markaudacity/Z88-Flash-Card/Z88 Flash KiCad/net report.csv

Net Code | Net Name | Pad Count | Via Count | Via Length (mm) | Track Length (mm) | Die Length (mm) | Net Length (mm) | F.Cu (mm) | In1.Cu (mm) | In2.Cu (mm) | B.Cu (mm)
001 | GND | 16 | 7 | 10.8150 | 51.6775 | 0.0000 | 62.4925 | 51.6775 | 0.0000 | 0.0000 | 0.0000
002 | VCC | 12 | 0 | 0.0000 | 134.6626 | 0.0000 | 134.6626 | 134.6626 | 0.0000 | 0.0000 | 0.0000
003 | /D2 | 4 | 3 | 2.9550 | 53.4608 | 0.0000 | 56.4158 | 16.6270 | 19.7758 | 17.0580 | 0.0000
004 | /D1 | 4 | 3 | 2.9550 | 55.8959 | 0.0000 | 58.8509 | 17.7764 | 20.1144 | 18.0051 | 0.0000
005 | /A14 | 4 | 4 | 4.3650 | 99.7862 | 0.0000 | 104.1512 | 13.5033 | 44.5184 | 41.7645 | 0.0000
006 | /D0 | 4 | 3 | 2.9550 | 53.8250 | 0.0000 | 56.7800 | 16.3816 | 20.3295 | 17.1139 | 0.0000
007 | /A13 | 4 | 4 | 3.0900 | 106.4675 | 0.0000 | 109.5575 | 14.3991 | 74.9579 | 17.1106 | 0.0000
008 | /A0 | 4 | 3 | 2.9550 | 65.6960 | 0.0000 | 68.6510 | 19.1505 | 28.4713 | 18.0742 | 0.0000
009 | /A8 | 4 | 4 | 3.0900 | 95.7026 | 0.0000 | 98.7926 | 18.8896 | 65.4914 | 11.3216 | 0.0000
010 | /A1 | 4 | 3 | 2.9550 | 54.8601 | 0.0000 | 57.8151 | 17.3188 | 20.4307 | 17.1106 | 0.0000
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
