markaudacity/Z88-Flash-Card/doc/z88-flash-mod.pdf

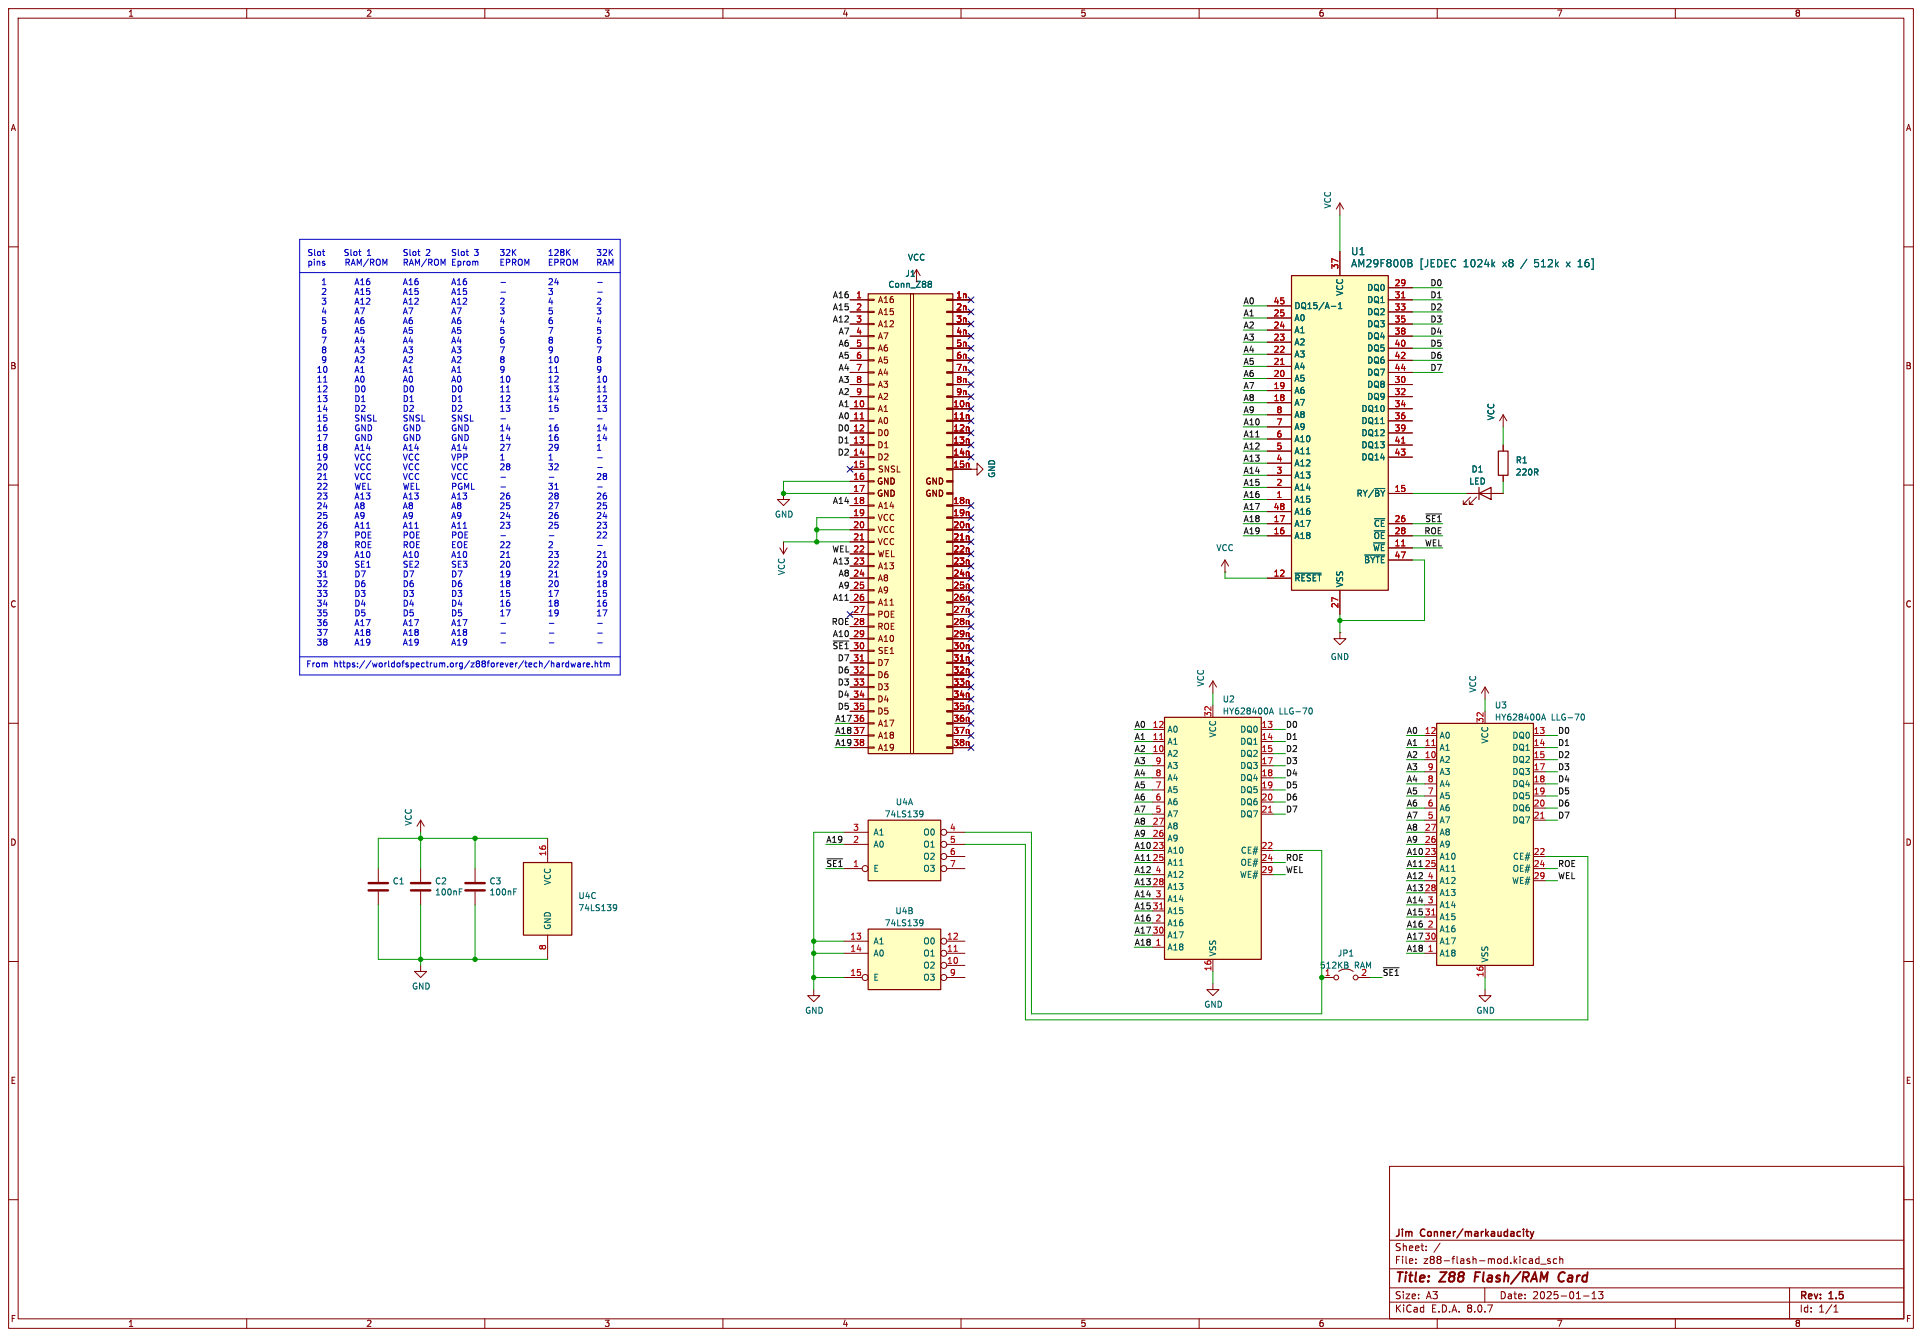
[picture p3: page 1]

17 GND GND GND 14 16 14
19 VCC VCC VPP 1 1 - 20 VCC VCC VCC 28 32 - 21 VCC VCC VCC - - 28

Id: 1/1 Title: Z88 Flash/RAM Card
