markaudacity/Z88-Flash-Card/(commit log)

2025-01-02 initial upload of modified files, removal of upstream files
    [connector.kicad_pcb, connector.kicad_sch, net report.csv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]
2025-01-02 removed connector-backups dir
2025-01-02 new Gerbers
    [z88-flash-mod-B_Cu.gbr, z88-flash-mod-B_Mask.gbr, z88-flash-mod-B_Paste.gbr, z88-flash-mod-B_Silkscreen.gbr, z88-flash-mod-Edge_Cuts.gbr, z88-flash-mod-F_Cu.gbr, z88-flash-mod-F_Mask.gbr, z88-flash-mod-F_Paste.gbr]
2025-01-02 ZIPped up neew Gerbers for easy fab upload
    [z88-flash-mod.kicad_pcb]
2025-01-02 new board routing and render images
2025-01-02 On branch main Your branch is up to date with 'origin/main'.
    Changes to be committed:
    new file: PCB-3D-render 2025.png
    new file: PCB-Routing 2025.png
    new file: Z88_1MB_Flash/Z88-1MB-Flash-mod.zip
    new file: Z88_1MB_Flash/z88-flash-mod-backups/z88-flash-mod-2025-01-02_165429.zip
2025-01-02 Changes to be committed: modified: README.md deleted: images/PCB-3D-render 2025.png deleted: images/PCB-Routing 2025.png
    Untracked files:
    images/PCB-3D-render-2025.png
    images/PCB-Routing-2025.png
2025-01-02 Changes to be committed: new file: images/PCB-3D-render-2025.png new file: images/PCB-Routing-2025.png
2025-01-06 minor edits
    [net report.csv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]
2025-01-13 small tweaks to schematic, silkscreen, edge cuts, added PDF plot of schematic
    [net report.csv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]
2025-01-14 file cleanup
    [net report.csv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]
